natrya/oximeter-mqtt/README.md

# oximeter-mqtt
oximeter mqtt idsecconf 2021

konfigurasi arduino untuk wemos D1 mini

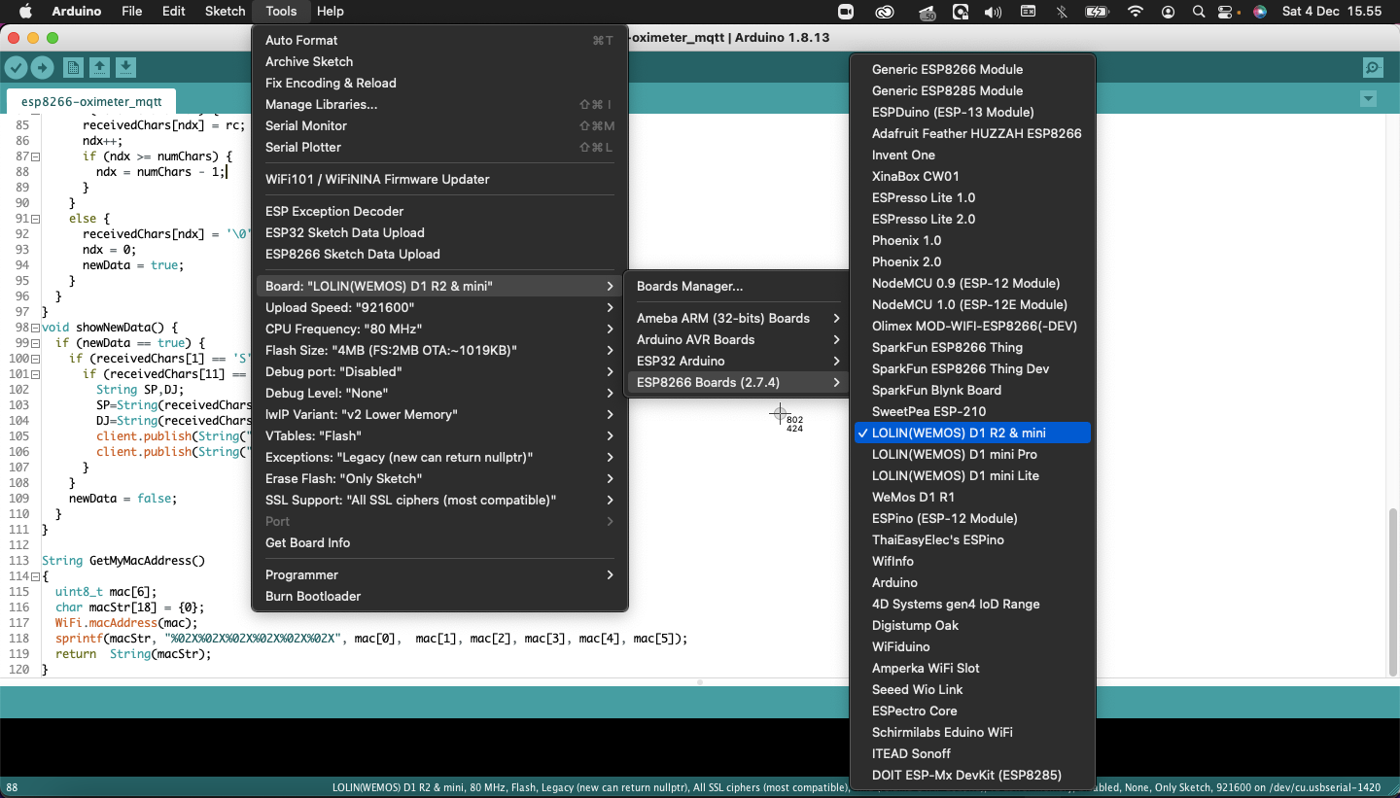
[picture p1: konfigurasi.png]
konfigurasi arduino


install mosquitto dengan konfigurasi SSL port 8883
